timovandrey/schneidbrett/grobrechnung_preis_teile.xlsx

Teil | Preis | Anzahl |  | Stück | 3
MAX604CSA+ | 6.14 | 1
USB4105-GF-A | 0.744 | 1
SJ-3523-SMT-TR | 0.865 | 2
DT6250-06MR-13 | 0.372 | 2
70246-2004 | 2.05 | 1
AD9833BRMZ | 12.36 | 1
LM4881MM/NOPB | 1.32 | 1
STM32F767ZIT6 | 18.35 | 1
DS01-254-L-01BE | 0.363 | 1
PTS645SM43SMTR92LFS | 0.205 | 3
CX2016SA25000F0FRZC1 | 0.642 | 1
FT230XQ-R | 2.1 | 1
 | Teile | Teile * Stück | PCB+Assembly | Total
 | 47.158 | 141.474 | 97.38 | 238.854 | €
