timovandrey/schneidbrett/schneidbrett.kicad_pcb

## KiCad design schneidbrett.kicad_pcb (2024-02-04)

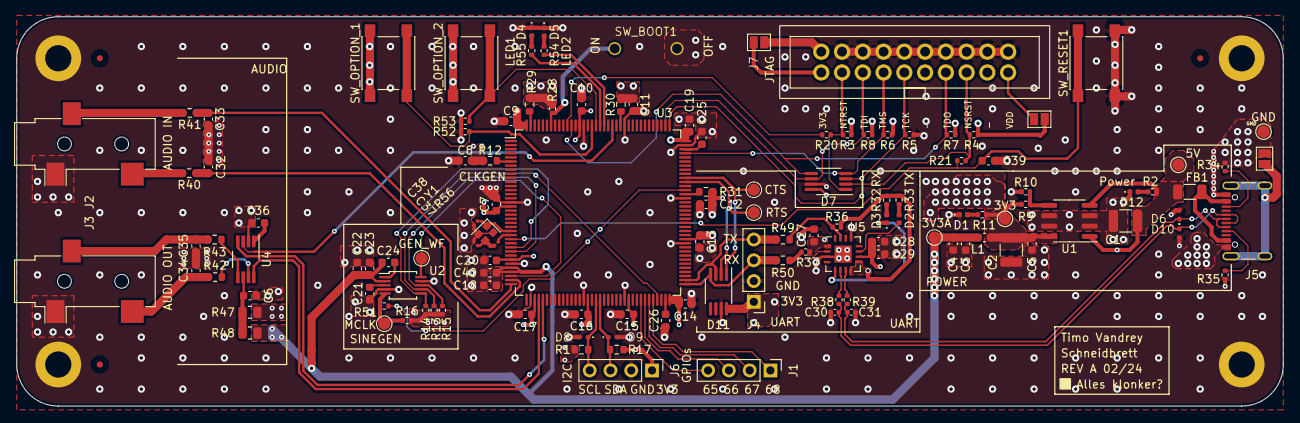
[picture p1: board schneidbrett.kicad_pcb from above]

Board: 4 copper layers, 154.9 x 47.6 mm, 134 parts (0 on the bottom side), 79 nets.

Parts:
3V3: PWR_TP_3V3; TestPoint_Pad_D1.5mm
3V3A: PWR_TP_3V3A; TestPoint_Pad_D1.5mm
5V: PWR_TP_5V; TestPoint_Pad_D1.5mm
C1, C2: 22u; C_1210_3225Metric
C3, C18: 1u; C_0603_1608Metric
C4, C5, C6, C7, C8, C9, C10, C11, C12, C13, C14, C15, C16, C17, C19, C20, C21, C23, C27, C28, C39, C40: 100n; C_0603_1608Metric
C22, C36: 10u; C_0603_1608Metric
C24: 10n; C_0603_1608Metric
C25, C26: 2u2; C_0603_1608Metric
C29: 4u7; C_0603_1608Metric
C30, C31: 47p; C_0402_1005Metric
C32, C33, C34, C35: 500n; C_0603_1608Metric
C37, C38: 10p; C_0201_0603Metric
CTS: CTS_ACCESS_PT; TestPoint_Pad_D1.5mm
D1, D12: SML-LX0402UPGC-TR; LED_0402_1005Metric
D2: SML-LX0402SIC-TR; LED_0402_1005Metric
D3: SML-LX0402SOC-TR; LED_0402_1005Metric
D4, D5: SML-LX0402USBC-TR; LED_0402_1005Metric
D6, D8, D9, D10: TVSA04V05C006
D7, D11: DT6250-06MR-13; MSOP-8_3x3mm_P0.65mm
FB1: 100R; C_1206_3216Metric
FID1, FID2, FID3: Fiducial; Fiducial_0.75mm_Mask2.25mm
GEN_WF: TestPoint; TestPoint_Pad_D1.5mm
GND: PWR_TP_GND; TestPoint_Pad_D1.5mm
H1, H2, H3, H4: MountingHole_Pad; MountingHole_3.2mm_M3_DIN965_Pad
J1: GPIO_CONNECTOR; PinHeader_1x04_P2.54mm_Vertical
J2: Audio_Jack_Input; Jack_3.5mm_CUI_SJ-3523-SMT_Horizontal
J3: Audio_Jack_Output; Jack_3.5mm_CUI_SJ-3523-SMT_Horizontal
J4: UART_CONNECTOR; PinHeader_1x04_P2.54mm_Vertical
J5: USB_C_Receptacle_USB2.0; USB_C_Receptacle_GCT_USB4105-xx-A_16P_TopMnt_Horizontal
J6: I2C_CONNECTOR; PinHeader_1x04_P2.54mm_Vertical
J7: ST-LINK_V2_20Pin_Connector
L1: 27n; C_0603_1608Metric
MCLK: TestPoint; TestPoint_Pad_D1.5mm
R1, R17: 5k1; R_0603_1608Metric
R2, R11, R54, R55: 680R; R_0402_1005Metric
R3, R4, R5, R6, R7, R8, R13, R14, R15, R16, R52, R53: 4k7; R_0402_1005Metric
R9, R10, R20, R21, R51: 0R; R_0402_1005Metric
R12, R29, R30, R31: 0R; R_0603_1608Metric
R28, R34, R35, R36, R37: 5k1; R_0402_1005Metric
R32, R33: 270R; R_0402_1005Metric
R38, R39: 27R; R_0402_1005Metric
R40, R41, R42, R43: 10R; R_0603_1608Metric
R47, R48: 0R; R_0805_2012Metric
R49, R50: 100R; R_0603_1608Metric
R56: 0R; R_0201_0603Metric
RTS: RTS_ACCESS_PT; TestPoint_Pad_D1.5mm
SW_BOOT1: SW_DIP_x01; DS01-254-L-01BE
SW_OPTION_1, SW_OPTION_2: PTS645SM43SMTR92 LFS; SW_SPST_PTS645
SW_RESET1: PTS645SM43SMTR92 LFS; SW_SPST_PTS645
TCB2, TCB3: SolderJumper-2_P1.3mm_Open_Pad1.0x1.5mm
TCB4: USB_SHIELDING_BRIDGE; SolderJumper-2_P1.3mm_Open_Pad1.0x1.5mm
U1: MAX604CSA; SOIC-8_3.9x4.9mm_P1.27mm
U2: AD9833xRM; MSOP-10_3x3mm_P0.5mm
U3: STM32F767ZITx; LQFP-144_20x20mm_P0.5mm
U4: LM4881M; VSSOP-8_3.0x3.0mm_P0.65mm
U5: FT230XQ; QFN-16-1EP_4x4mm_P0.65mm_EP2.1x2.1mm
Y1: 25MHz; Crystal_SMD_2016-4Pin_2.0x1.6mm

Connections:
+3.3V: 3V3.1, C2.1, C5.1, C7.1, C8.1, C9.1, C10.1, C11.1, C12.1, C13.1, C14.1, C15.1, C16.1, C17.1, C19.1, C20.1, D7.8 (VCC), D11.8 (VCC), J4.1, J6.1, J7.1 (VREF), L1.1, R1.1, R3.2, R4.2, R6.2, R7.2, R8.2, R9.2, R11.2, R12.1, R13.2, R14.2, R15.2, R16.2, R17.1, R28.2, R29.1, R30.1, R31.1, R47.2, SW_OPTION_1.1, SW_OPTION_2.1, TCB2.1, TCB3.1, U1.8 (OUT), U3.17 (VDD), U3.30 (VDD), U3.39 (VDD), U3.52 (VDD), U3.62 (VDD), U3.72 (VDD), U3.84 (VDD), U3.108 (VDD), U3.131 (VDD), U3.144 (VDD)
+3.3VA: 3V3A.1, C3.1, C4.1, C18.1, C22.1, C23.1, C24.1, C40.1, L1.2, R48.2, U2.2 (VDD), U3.32 (VREF+), U3.33 (VDDA)
+5V: 5V.1, C1.1, C28.1, C29.1, FB1.2, R2.2, U1.1 (IN), U1.4 (~OFF), U5.10 (VCC)
+VCCIO_FTDI: C27.1, R32.2, R33.2, R36.2, R37.2, U5.1 (VCCIO), U5.8 (3V3OUT), U5.9 (~RESET)
/Analog/AUDIO_BYPASS: C36.1, U4.1 (BYPASS)
/Analog/AUDIO_PWR_JUNCTION: C6.1, R47.1, R48.1, U4.6 (VDD)
/Analog/GEN_CAP: C21.2, U2.3 (CAP/2.5V)
/Analog/GEN_COMP: C24.2, U2.1 (COMP)
/Analog/GEN_MCLK: MCLK.1, R16.1, R51.2, U2.5 (MCLK)
/Connectors/JTAG_NSRST_INNER: D7.2 (IO2), J7.15 (~SRST), R4.1, R21.1
/Connectors/JTAG_NTRST_INNER: D7.1 (IO1), J7.3 (~TRST), R3.1, R20.1
/Connectors/USB_CC1: J5.A5 (CC1), R35.1
/Connectors/USB_CC2: J5.B5 (CC2), R34.1
/Connectors/USB_SHIELDING: J5.S1 (SHIELD), TCB4.1
/Controller/GPIO_LED_1_JUNCTION: D4.2 (A), R55.1
/Controller/GPIO_LED_2_JUNCTION: D5.2 (A), R54.1
/Controller/MCU_BOOT0: R28.1, SW_BOOT1.2, U3.138 (BOOT0)
/Controller/MCU_CRYSTAL_3: C37.1, R56.1, Y1.3
/Controller/MCU_PDR_ON: R29.2, U3.143 (PDR_ON)
/Controller/MCU_VBAT: R12.2, U3.6 (VBAT)
/Controller/MCU_VDDSDMMC: R30.2, U3.121 (VDDSDMMC)
/Controller/MCU_VDDUSB: R31.2, U3.95 (VDDUSB)
/Peripherals/FTDI_CBUS1: D2.1 (K), U5.11 (CBUS1)
/Peripherals/FTDI_CBUS2: D3.1 (K), U5.5 (CBUS2)
/Peripherals/FTDI_LED1: D2.2 (A), R33.1
/Peripherals/FTDI_LED2: D3.2 (A), R32.1
/Power Supply/POWER_LED_3V3: D1.2 (A), R11.1
/Power Supply/POWER_LED_5V: D12.2 (A), R2.1
/Power Supply/POWER_SET_TERMINAL: R9.1, R10.2, U1.5 (SET)
Audio_In_Left: J2.T, R40.2
Audio_In_Left_Filtered: C32.1, R40.1, U3.35 (PA1)
Audio_In_Right: J2.R, R41.2
Audio_In_Right_Filtered: C33.1, R41.1, U3.36 (PA2)
Audio_Out_Left: R42.2, U4.7 (OUT_A)
Audio_Out_Left_Filtered: C34.1, J3.T, R42.1
Audio_Out_Left_MCU: U3.40 (PA4), U4.8 (IN_A)
Audio_Out_Right: R43.2, U4.5 (OUT_B)
Audio_Out_Right_Filtered: C35.1, J3.R, R43.1
Audio_Out_Right_MCU: U3.41 (PA5), U4.4 (IN_B)
Audio_Shutdown: U3.123 (PD7), U4.3 (SHUTDOWN)
FTDI_UART_RX: R37.1, R50.2, U5.2 (RXD)
FTDI_UART_TX: R36.1, R49.2, U5.15 (TXD)
FTDI_USBD+: R38.1, U5.6 (USBDP)
FTDI_USBD-: R39.1, U5.7 (USBDM)
GEN_REFCLK: R51.1, U3.96 (PC6)
GEN_SPI_CLK: R13.1, U2.7 (SCLK), U3.69 (PB10)
GEN_SPI_CSEL: R15.1, U2.8 (~FSYNC), U3.28 (PC2)
GEN_SPI_DATA: R14.1, U2.6 (SDATA), U3.27 (PC1)
GEN_WAVEFORM: GEN_WF.1, U2.10 (VOUT), U3.34 (PA0)
GND: C1.2, C2.2, C3.2, C4.2, C5.2, C6.2, C7.2, C8.2, C9.2, C10.2, C11.2, C12.2, C13.2, C14.2, C15.2, C16.2, C17.2, C18.2, C19.2, C20.2, C21.1, C22.2, C23.2, C25.2, C26.2, C27.2, C28.2, C29.2, C30.2, C31.2, C32.2, C33.2, C34.2, C35.2, C36.2, C37.2, C38.2, C39.2, C40.2, D1.1 (K), D4.1 (K), D5.1 (K), D6.1, D7.7 (VSS), D8.1, D9.1, D10.1, D11.7 (VSS), D12.1 (K), GND.1, H1.1, H2.1, H3.1, H4.1, J2.S, J3.S, J4.2, J5.A1 (GND), J5.A12 (GND), J5.B1 (GND), J5.B12 (GND), J6.2, J7.4 (GND), J7.6 (GND), J7.8 (GND), J7.10 (GND), J7.12 (GND), J7.14 (GND), J7.16 (GND), J7.18 (GND), J7.20 (GND), R5.1, R10.1, R34.2, R35.2, R52.1, R53.1, SW_BOOT1.1, SW_RESET1.2, TCB4.2, U1.2 (GND), U1.3 (GND), U1.6 (GND), U1.7 (GND), U2.4 (DGND), U2.9 (AGND), U3.16 (VSS), U3.31 (VSSA), U3.38 (VSS), U3.51 (VSS), U3.61 (VSS), U3.83 (VSS), U3.94 (VSS), U3.107 (VSS), U3.120 (VSS), U3.130 (VSS), U4.2 (GND), U5.3 (GND), U5.13 (GND), U5.17 (GND), Y1.2, Y1.4
GPIO_BTN_1: R52.2, SW_OPTION_1.2, U3.128 (PG13)
GPIO_BTN_2: R53.2, SW_OPTION_2.2, U3.127 (PG12)
GPIO_LED_1: R55.2, U3.126 (PG11)
GPIO_LED_2: R54.2, U3.125 (PG10)
GPIO_OPT_0: J1.4, U3.65 (PE12)
GPIO_OPT_1: J1.3, U3.66 (PE13)
GPIO_OPT_2: J1.2, U3.67 (PE14)
GPIO_OPT_3: J1.1, U3.68 (PE15)
JTAG_NSRST: C39.1, R21.2, SW_RESET1.1, U3.25 (NRST)
JTAG_NTRST: R20.2, U3.134 (PB4)
JTAG_TCK: D7.3 (IO3), J7.9 (TCK/SWCLK), R5.2, U3.109 (PA14)
JTAG_TDI: D7.6 (IO6), J7.5 (TDI), R8.1, U3.110 (PA15)
JTAG_TDO: D7.5 (IO5), J7.13 (TDO/SWO), R7.1, U3.133 (PB3)
JTAG_TMS: D7.4 (IO4), J7.7 (TMS/SWDIO), R6.1, U3.105 (PA13)
MCU_CRYSTAL_PH0: C38.1, U3.23 (PH0), Y1.1
MCU_CRYSTAL_PH1: R56.2, U3.24 (PH1)
MCU_I2C_SCL: D8.2, J6.4, R1.2, U3.54 (PF14)
MCU_I2C_SDA: D9.2, J6.3, R17.2, U3.55 (PF15)
MCU_UART_CTS: CTS.1, D11.1 (IO1), U3.99 (PC9)
MCU_UART_RTS: D11.2 (IO2), RTS.1, U3.98 (PC8)
MCU_UART_RX: D11.4 (IO4), J4.3, R50.1, U3.73 (PB12)
MCU_UART_TX: D11.3 (IO3), J4.4, R49.1, U3.74 (PB13)
unnamed: J7.2 (VAPP), TCB2.2
unnamed: J7.19 (VDD), TCB3.2
unnamed: C26.1, U3.71 (VCAP_1)
unnamed: C25.1, U3.106 (VCAP_2)
USB+: C30.1, D10.2, J5.A6 (D+), J5.B6 (D+), R38.2
USB-: C31.1, D6.2, J5.A7 (D-), J5.B7 (D-), R39.2
VBUS: FB1.1, J5.A4 (VBUS), J5.A9 (VBUS), J5.B4 (VBUS), J5.B9 (VBUS)
