timovandrey/schneidbrett/schneidbrett.ioc

Mcu.UserName=STM32F767ZITx
PA0/WKUP.GPIO_Label=GEN_INPUT
PA0/WKUP.Signal=ADCx_IN0
PA1.GPIO_Label=AUDIO_IN_LEFT
PA1.Signal=ADCx_IN1
PA13.Signal=SYS_JTMS-SWDIO
PA14.Signal=SYS_JTCK-SWCLK
PA15.Signal=SYS_JTDI
PA2.GPIO_Label=AUDIO_IN_RIGHT
PA2.Signal=ADCx_IN2
PA4.GPIO_Label=AUDIO_OUT_LEFT
PA4.Signal=COMP_DAC1_group
PA5.GPIO_Label=AUDIO_OUT_RIGHT
PA5.Signal=COMP_DAC2_group
PB10.Signal=SPI2_SCK
PB12.Signal=UART5_RX
PB13.Signal=UART5_TX
PB3.Signal=SYS_JTDO-SWO
PB4.Signal=SYS_JTRST
PC1.Signal=SPI2_MOSI
PC2.GPIO_Label=SPI2_CSEL
PC2.Signal=GPIO_Output
PC6.Signal=S_TIM8_CH1
PC8.Signal=UART5_RTS
PC9.Signal=UART5_CTS
PD7.GPIO_Label=AUDIO_MUTE
PD7.Signal=GPIO_Output
PE12.Signal=GPIO_Input
PE13.Signal=GPIO_Input
PE14.Signal=GPIO_Input
PE15.Signal=GPIO_Input
PF14.Signal=I2C4_SCL
PF15.Signal=I2C4_SDA
PG10.GPIO_Label=LED2
PG10.Signal=GPIO_Output
PG11.GPIO_Label=LED1
PG11.Signal=GPIO_Output
PG12.GPIO_Label=BTN2
PG12.Signal=GPIO_Input
PG13.GPIO_Label=BTN1
PG13.Signal=GPIO_Input
