timovandrey/schneidbrett/(commit log)

2024-01-08 Added ESD, updated Footprints, BOM, etc.
    [analog.kicad_sch, connectors.kicad_sch, controller.kicad_sch, peripherals.kicad_sch, powersupply.kicad_sch, schneidbrett.csv, schneidbrett.kicad_pcb, schneidbrett.kicad_sch]
2024-01-13 Schematic is done for now, starting layout
    [analog.kicad_sch, connectors.kicad_sch, controller.kicad_sch, peripherals.kicad_sch, powersupply.kicad_sch, schneidbrett.kicad_pcb, schneidbrett.kicad_sch]
2024-01-14 Layout done, footprints mostly assigned, 3D models assigned if not annoying to get. Few TODOs left and they are marked on the PCB.
    [analog.kicad_sch, connectors.kicad_sch, controller.kicad_sch, powersupply.kicad_sch, schneidbrett.kicad_pcb]
2024-01-16 Board outline finished, component placement, added markers, added annotations, etc.
    [connectors.kicad_sch, controller.kicad_sch, powersupply.kicad_sch, schneidbrett.kicad_pcb]
2024-01-23 Layout and routing basically done, check again before delivering
    [analog.kicad_sch, connectors.kicad_sch, peripherals.kicad_sch, schneidbrett.kicad_pcb]
2024-02-04 Routing, Zone fillings, stitching vias, etc.
    - Routing is now done, unconnected pads are connected now
    - Ground pour on top and bottom layer; other zones were changed for
    compliance
    - Other routing and connections
    - Stitching vias
    - Other minor changes
    [schneidbrett.kicad_pcb]
2024-02-04 Final finish
    - Added silkscreen notes
    - Updated FTDI chip datasheet link
    - Added BOM, Gerber-Files
    - Added (coarse) calculation sheet for parts
    - Minor changes, maybe
    [grobrechnung_preis_teile.xlsx, peripherals.kicad_sch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]
2024-02-12 Added voltage ratings for capacitors
    [bom.xlsx]
2024-02-12 Added capacitor voltage rating
    [analog.kicad_sch, controller.kicad_sch, peripherals.kicad_sch, powersupply.kicad_sch]
